1811htsang/PdM-AF/project-kicadspace/max9812/MAX9812LEXT/MAX9812LEXT.step

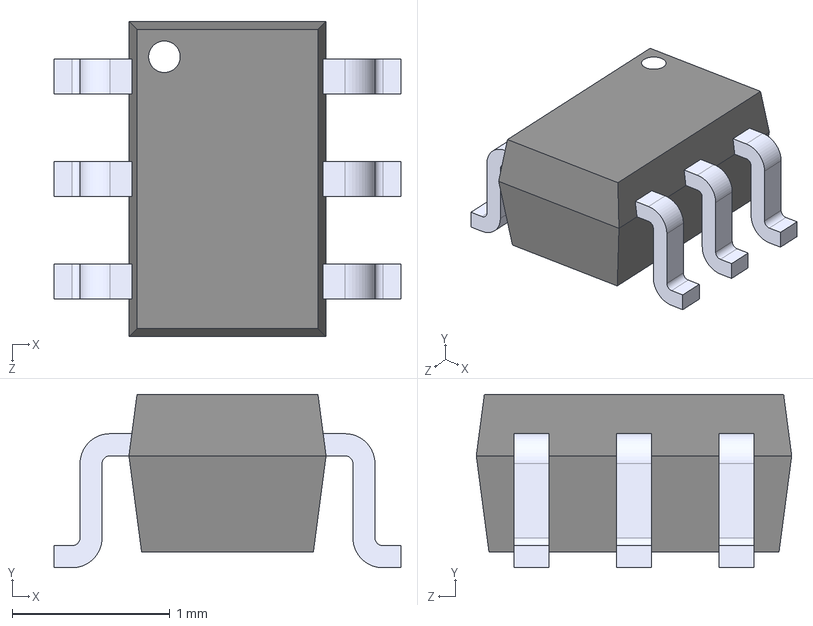
[picture p1: CAD file, 2026-10-03]
project-kicadspace/max9812/MAX9812LEXT/MAX9812LEXT.step
2.20 x 1.10 x 2.00 mm
