1811htsang/PdM-AF/prjecobj_ltspice/sample_v0.asc

CB: cap; 10µ
CG: cap; 10µ
CIN: cap; 1µ
CLP: cap; 1n
COUT: cap; 10µ
RADC: res; 60k
RB1: res; 100k
RB2: res; 100k
RF: res; 30k
RG: res; 10k
RIN: res; 100k
RLP: res; 1k
U1: UniversalOpAmp2
VCC: voltage; DC 12
VIN: voltage; ""; AC 1
VREF: voltage; DC 2.5
Named nets: 0
.ac dec 100 1 100k
