1811htsang/PdM-AF/prjecobj_kicad/kicadobj/kicadobj.kicad_pcb

## KiCad design prjecobj_kicad/kicadobj/kicadobj.kicad_pcb (2026-11-04)

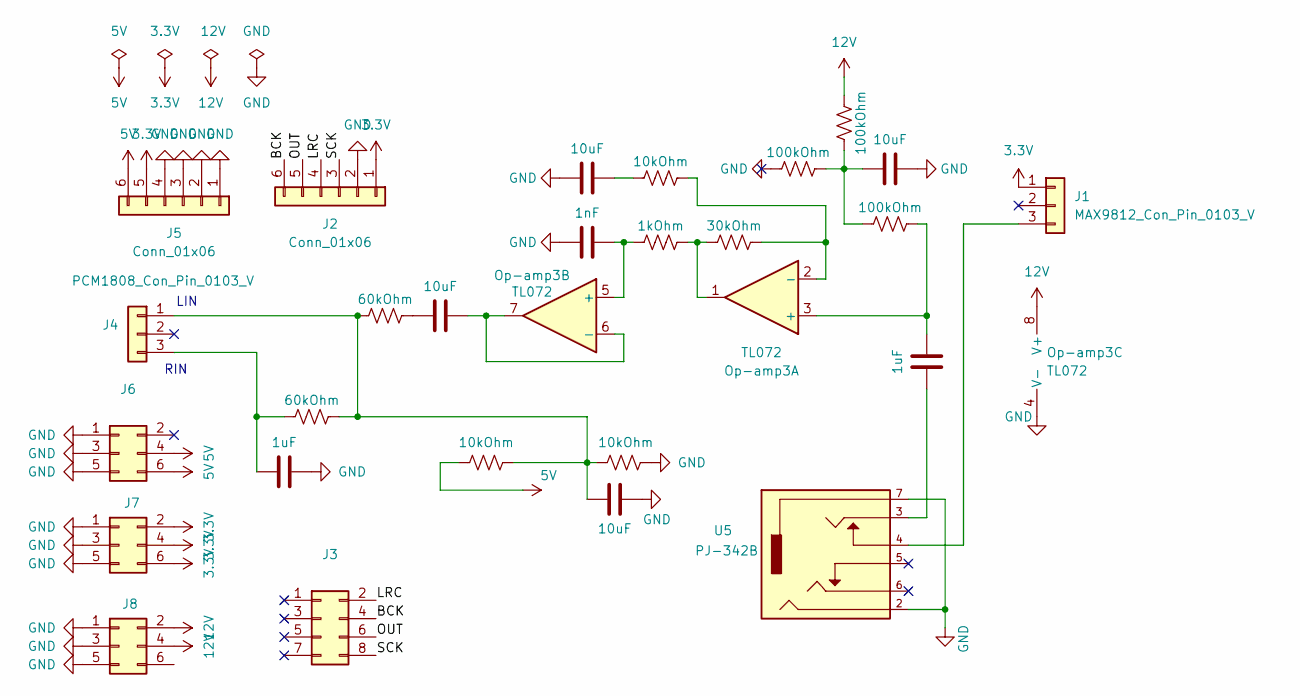
[picture p2: schematic kicadobj.kicad_sch]

Parts:
C13, C25, C26, C30: 10uF; C_0805_2012Metric
C23, C31: 1uF; C_0805_2012Metric
C29: 1nF; C_0805_2012Metric
J1: MAX9812_Con_Pin_0103_V; PinHeader_1x03_P2.54mm_Vertical
J2, J5: Conn_01x06; PinHeader_1x06_P2.54mm_Vertical
J3: Conn_02x04_Odd_Even; PinSocket_2x04_P2.54mm_Vertical
J4: PCM1808_Con_Pin_0103_V; PinHeader_1x03_P2.54mm_Vertical
J6, J7, J8: Conn_02x03_Odd_Even; PinSocket_2x03_P2.54mm_Vertical
Op-amp3: TL072; SOIC127P600X175-8N
R2, R3, R32: 10kOhm; R_0805_2012Metric
R26, R27, R29: 100kOhm; R_0805_2012Metric
R30: 30kOhm; R_0805_2012Metric
R31: 1kOhm; R_0805_2012Metric
R33, R34: 60kOhm; R_0805_2012Metric
U5: PJ-342B

Connections:
3.3V: J1.1, J2.1, J5.5, J7.2, J7.4, J7.6
5V: J5.6, J6.4, J6.6, R2.1
12V: J8.2, J8.4, Op-amp3.8 (V+), R27.1
/BCK: J2.6, J3.4
/LRC: J2.4, J3.2
/OUT: J2.5, J3.6
/SCK: J2.3, J3.8
GND: C13.1, C25.2, C29.1, C30.1, C31.2, J2.2, J5.1, J5.2, J5.3, J5.4, J6.1, J6.3, J6.5, J7.1, J7.3, J7.5, J8.1, J8.3, J8.5, Op-amp3.4 (V-), R3.2, R29.1, U5.2, U5.7
unnamed: C23.1, U5.3
unnamed: C25.1, R26.1, R27.2, R29.2
unnamed: C26.1, R33.2
unnamed: C30.2, R32.1
unnamed: J1.3, U5.4
unnamed: C13.2, J4.1, R2.2, R3.1, R33.1, R34.2
unnamed: C31.1, J4.3, R34.1
unnamed: Op-amp3.1, R30.1, R31.2
unnamed: C23.2, Op-amp3.3 (+), R26.2
unnamed: Op-amp3.2 (-), R30.2, R32.2
unnamed: C29.2, Op-amp3.5 (+), R31.1
unnamed: C26.2, Op-amp3.6 (-), Op-amp3.7

Notes on the sheet:
RIN
LIN

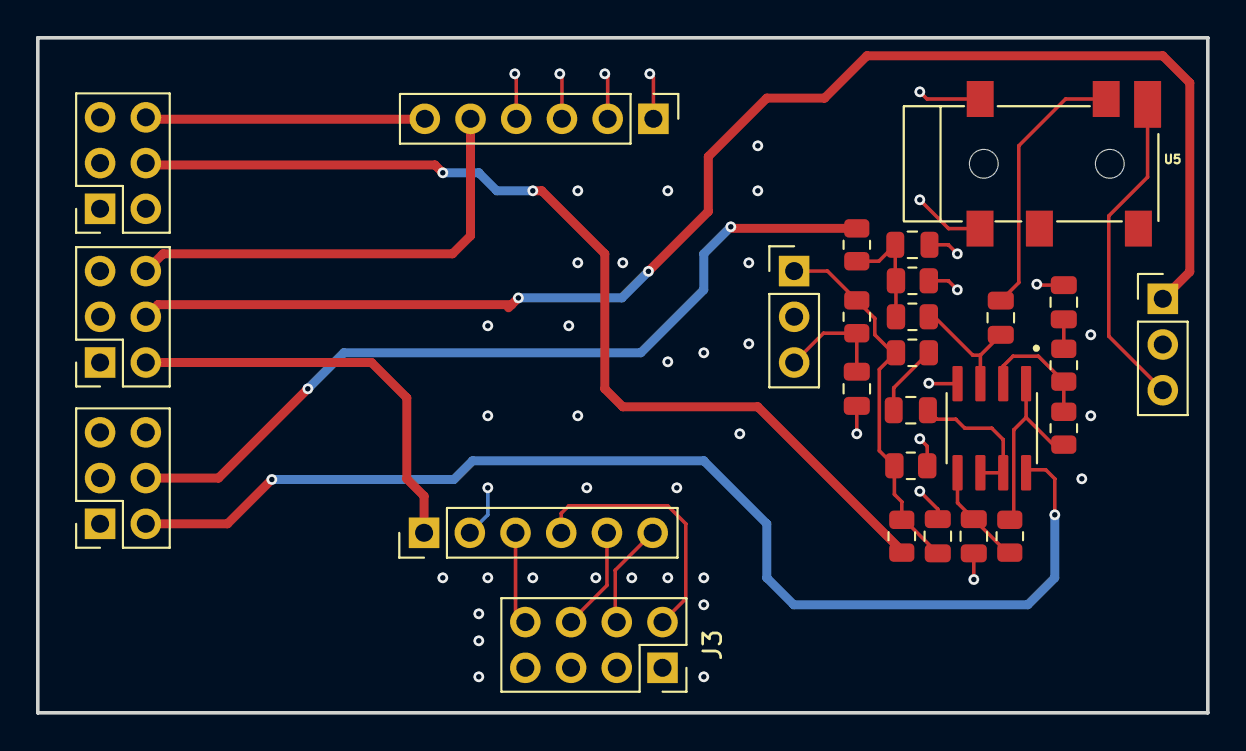
[picture p3: board kicadobj.kicad_pcb from above]

Board: 2 copper layers, 65.0 x 37.5 mm, 27 parts (0 on the bottom side), 20 nets.
