1811htsang/PdM-AF/(commit log)

2026-10-03 feat(kicad)[sang]: update new project kicad to replace old and missing library
2026-10-03 feat(kicad): reorder used designators for improved readability
2026-10-16 feat(prjecobj_kicad)[sang]: update old schematics into new prototype using LTSpice design
2026-10-25 feat(kicad): update net inspector panel configuration for improved visibility
2026-10-25 feat(kicad): enhance design settings with new defaults and rules for improved PCB layout
2026-10-25 feat(kicad): update schematics and ad new PCB design with remove PCM1808 item and replace with pin connector
2026-10-25 feat(kicad): add complete new sample for PCB design with using pin header, instead of module item
2026-10-25 feat(kicad): update active layer setting to improve PCB design workflow
2026-10-25 feat(kicad): update pcb with updating footprint
2026-10-27 feat(kicad): update used designators for improved component tracking
2026-10-27 feat(kicad): update connector from 1x5 to 1x6 with adding net
2026-11-01 feat(kicad): reset active layer to 0 for improved PCB design clarity
2026-11-01 feat(kicad): update schematics with pierce oscillator removal
2026-11-01 feat(subkicadobj): add intermediate pcb for routing from hardware to module
2026-11-02 feat(PdM-AF): update record module with removing 2-side to 1-side 2x10 pin
2026-11-02 feat(subkicad): update sub kicad module with removing (2x10 + 2x6 + 2x12) into (2x10 + 2x6)
2026-11-04 feat(kicad): update submodule and main record module for export
